abhishek-kakkar/beaglelogic-standalone/README.md

# beaglelogic-standalone

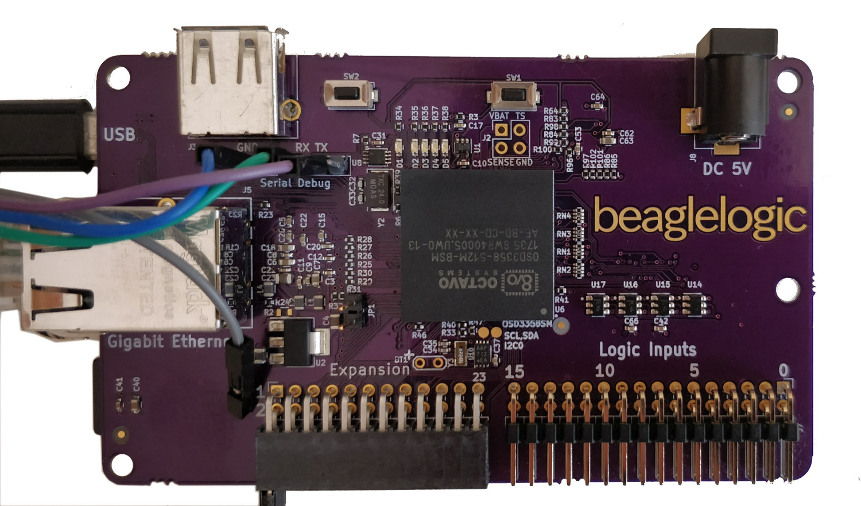
[picture p1: beaglelogic-standalone-top.jpg]
BeagleLogic standalone


BeagleLogic implemented as a turnkey and standalone logic analyzer
