abhishek-kakkar/beaglelogic-standalone/docs/tech_specs.rst

Technical Specifications
=========================

 * **Sample Rate**: 1 Hz to 100MHz (16 channels)
 * **Sample Depth**: Default 128 MiB, can be increased up to 300MiB
   (3 seconds, 8 channels or 1.5 seconds at 16 channels)
 * **Input impedance**: 1 MOhm on each channel
 * **Logic level thresholds supported**: 1.8V, 3.3V.
 * **Max voltage on a logic input pin**: currently 5V. Hardware can support
   taking up to 12V logic levels in a future revision
 * **Interfaces**: USB 2.0 Host and Client, Gigabit Ethernet.
