abhishek-kakkar/beaglelogic-standalone/beaglelogic-standalone.kicad_pcb

## KiCad design beaglelogic-standalone.kicad_pcb (2017-10-14)

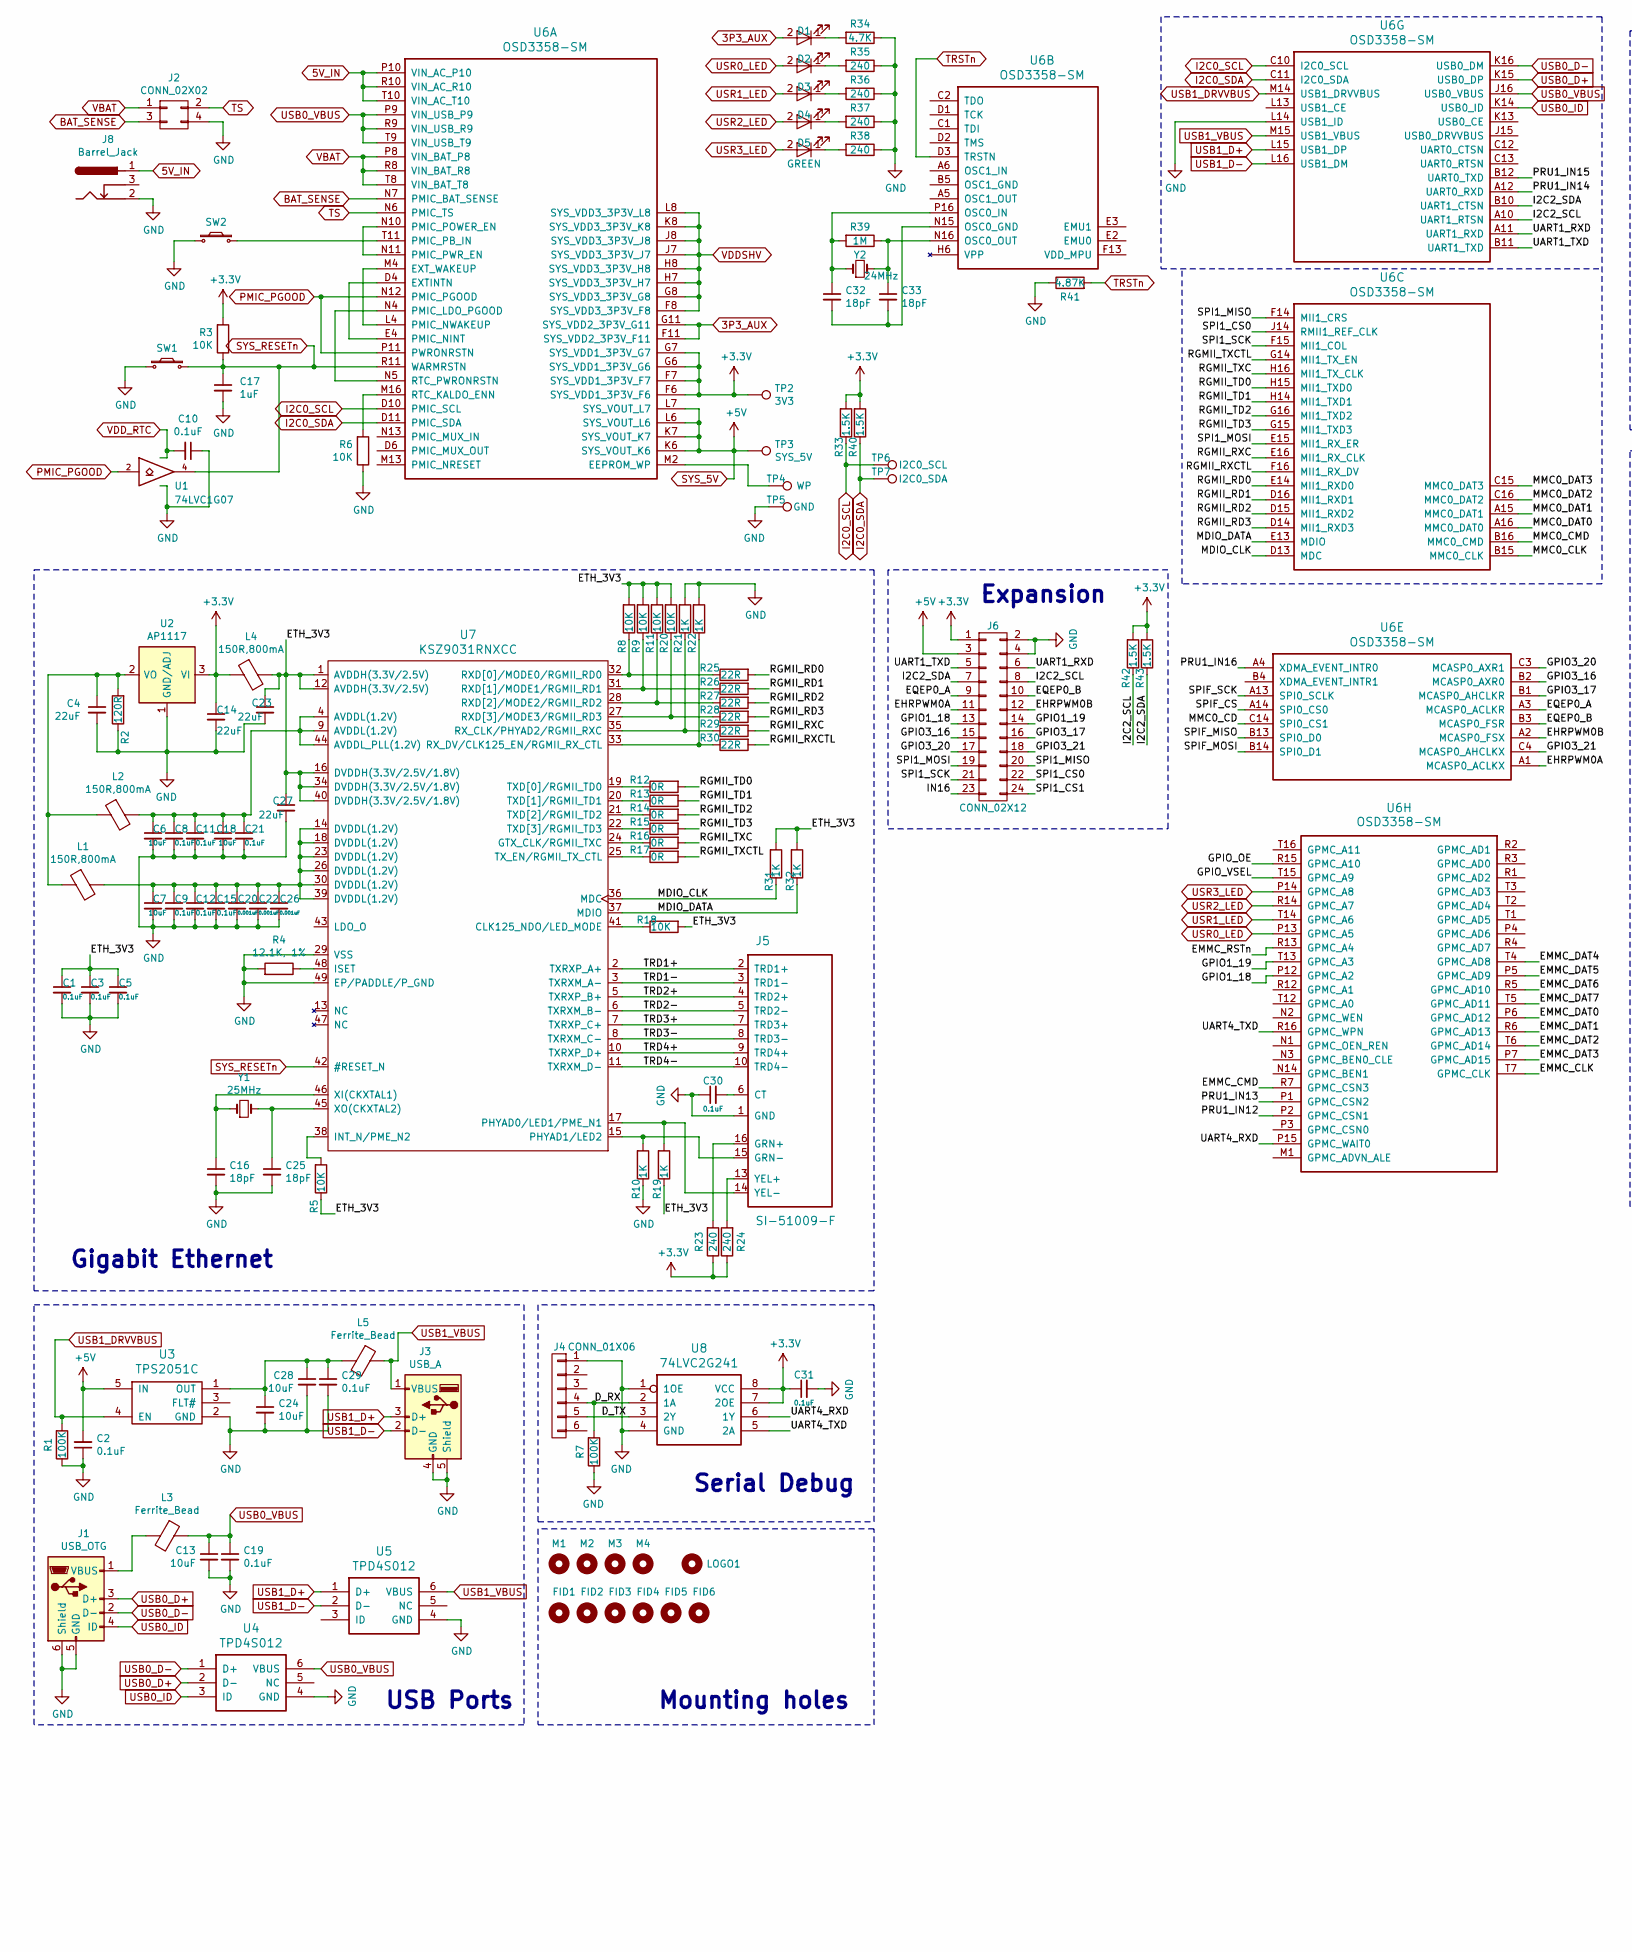
[picture p6: schematic beaglelogic-standalone.sch, BeagleLogic Standalone, part in row 1, column 1]

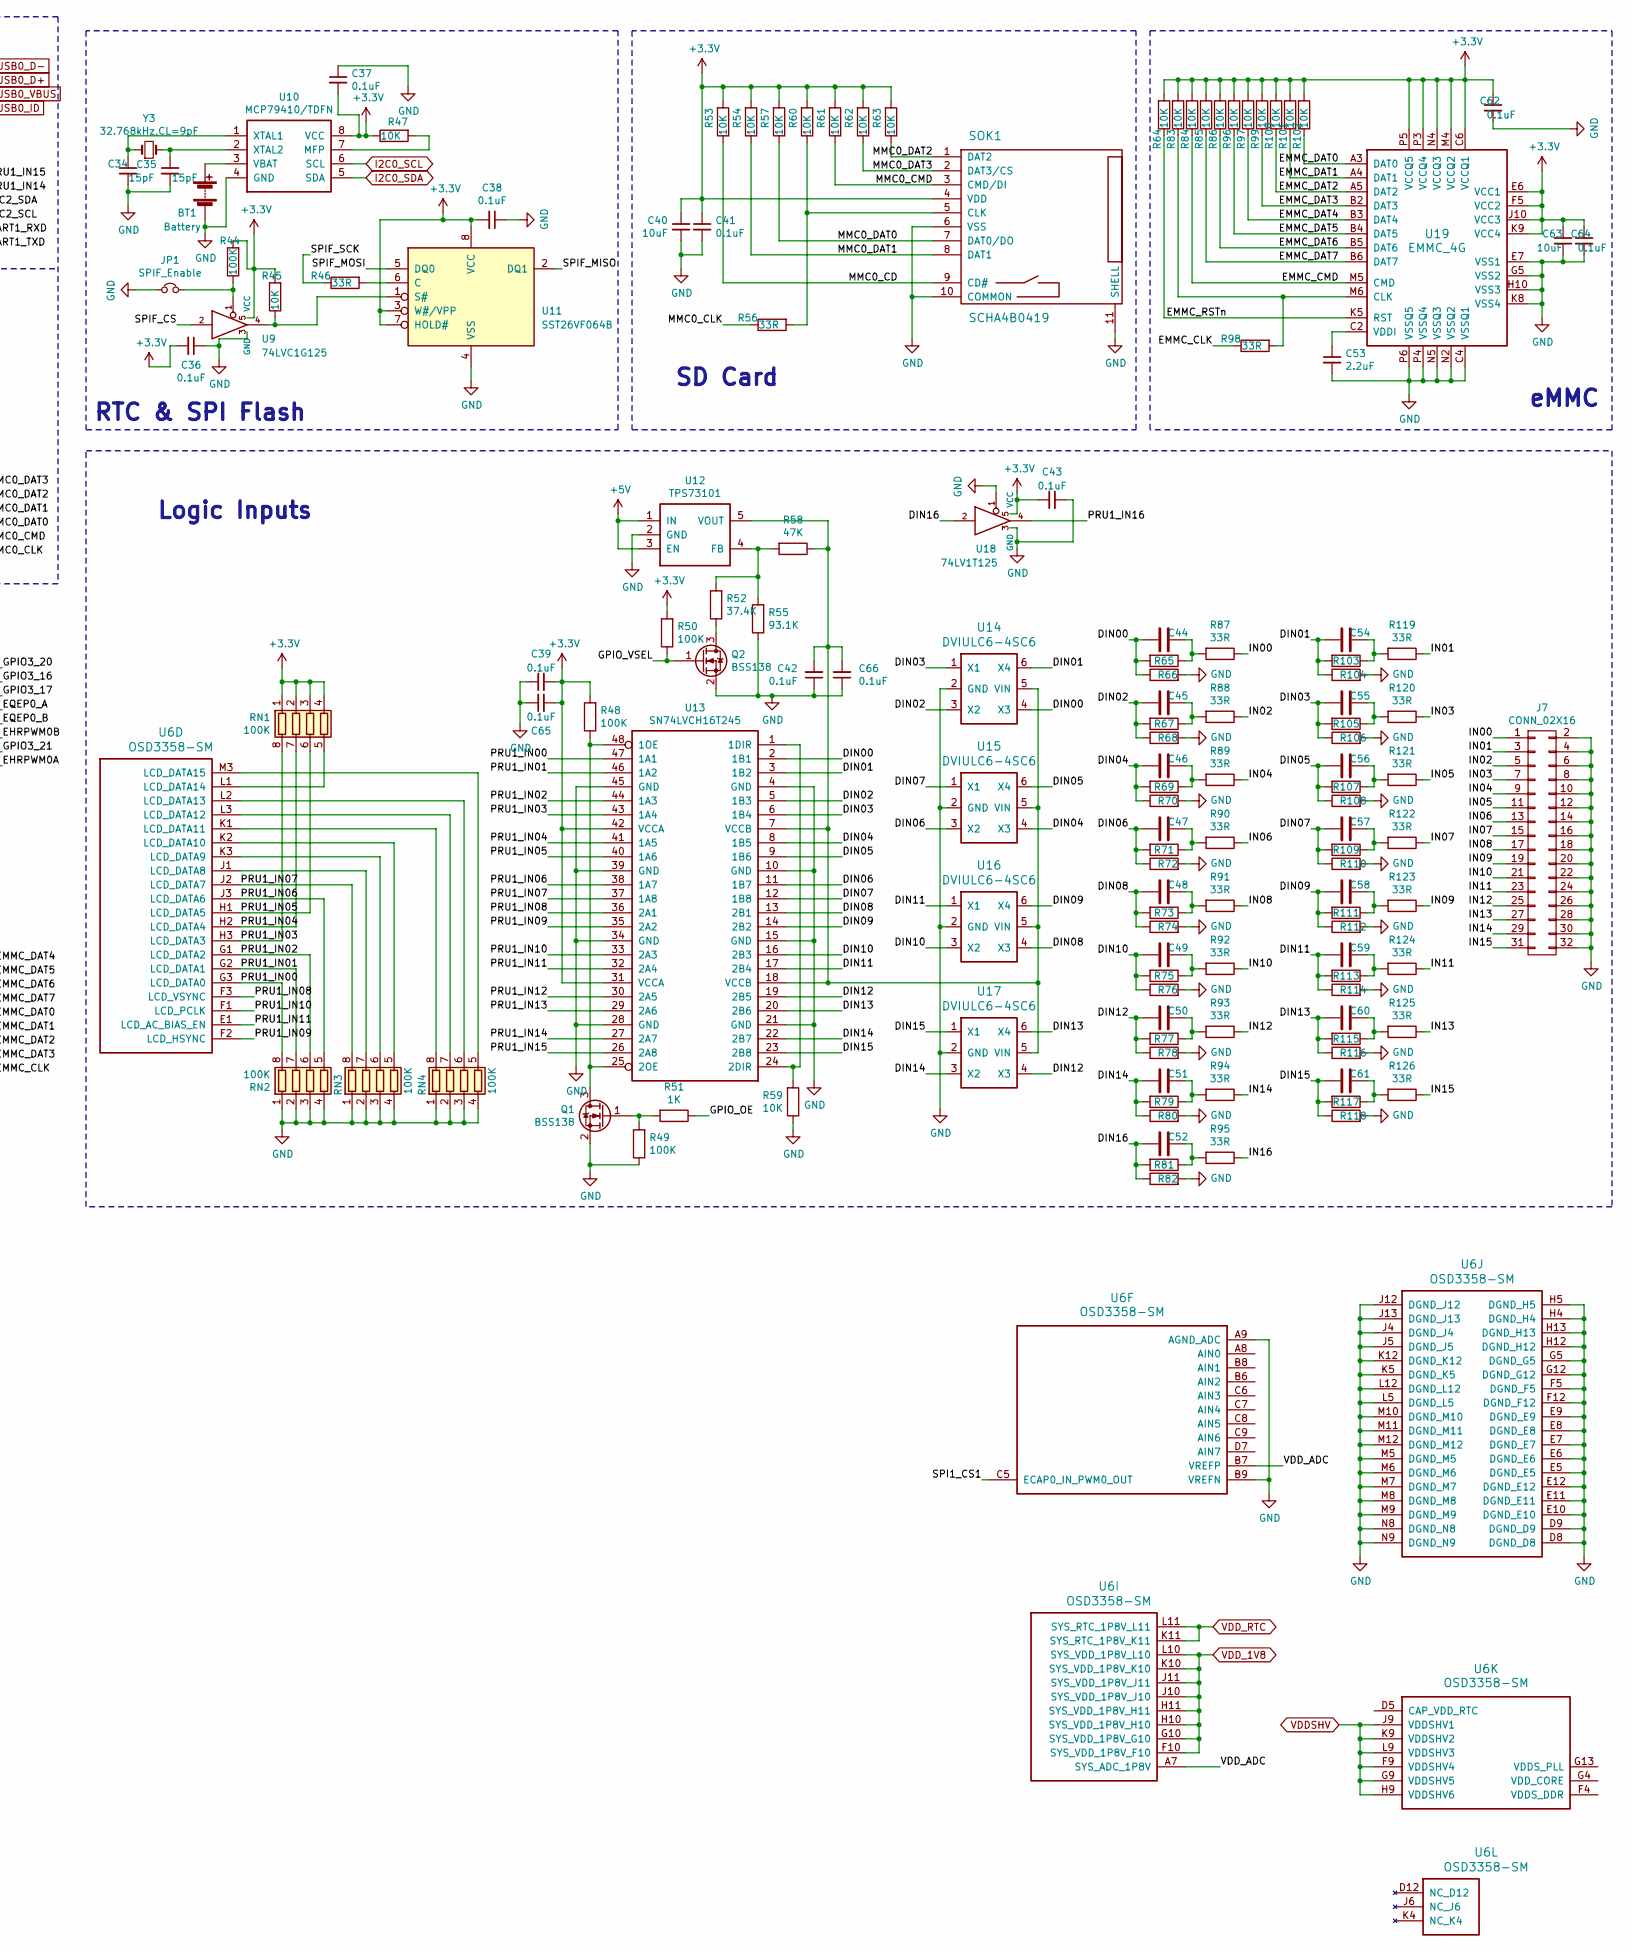
[picture p7: schematic beaglelogic-standalone.sch, BeagleLogic Standalone, part in row 1, column 2]

Parts:
BT1: Battery; Test_Point_2Pads
C1, C2, C3, C5, C8, C9, C10, C11, C12, C15, C19, C21, C29, C30, C31, C36, C37, C38, C39, C41, C42, C43, C62, C64, C65, C66: 0.1uF; C_0402
C4, C14, C23, C27: 22uF; C_0603
C6, C7, C13, C18, C24, C28, C40, C63: 10uF; C_0603
C16, C25, C32, C33: 18pF; C_0402
C17: 1uF; C_0402
C20, C22, C26: 0.001uF; C_0402
C34, C35: 15pF; C_0402
C44, C45, C46, C47, C48, C49, C50, C51, C52, C54, C55, C56, C57, C58, C59, C60, C61: 1pF, DNI; C_0402
C53: 2.2uF; C_0402
D1, D2, D3, D4, D5: GREEN; LED_0603
FID1, FID2, FID3, FID4, FID5, FID6: Mounting_Hole; Fiducial_1mm_Dia_2.54mm_Outer_CopperTop
J1: USB_OTG; 10118192-0001LF
J2: CONN_02X02; Pin_Header_Straight_2x02_Pitch2.54mm
J3: USB_A
J4: CONN_01X06; Pin_Header_Straight_1x06_Pitch2.54mm
J5: SI-51009-F
J6: CONN_02X12; Pin_Header_Angled_2x12_Pitch2.54mm_reversed
J7: CONN_02X16; Pin_Header_Angled_2x16_Pitch2.54mm
J8: Barrel_Jack; BARREL_JACK
JP1: SPIF_Enable; Test_Point_2Pads
L1, L2, L4: 150R,800mA; R_0603
L3, L5: Ferrite_Bead; R_0603
LOGO1: TEST_1P; beaglelogic-logo
M1, M2, M3, M4: TEST_1P; MountingHole_3.2mm_M3
Q1, Q2: BSS138; SOT-23
R1, R7, R44, R48, R49, R50: 100K; R_0402
R2: 120R; R_0603
R3, R5, R6, R8, R9, R11, R18, R20, R45, R47, R53, R54, R57, R59, R60, R61, R62, R63, R64, R83, R84, R85, R86, R96, R97, R99, R100, R101, R102: 10K; R_0402
R4: 12.1K, 1%; R_0402
R10, R19, R21, R22, R31, R32, R51: 1K; R_0402
R12, R13, R14, R15, R16, R17: 0R; R_0402
R23, R24, R35, R36, R37, R38: 240; R_0402
R25, R26, R27, R28, R29, R30: 22R; R_0402
R33, R40, R42, R43: 1.5K; R_0402
R34: 4.7K; R_0402
R39: 1M; R_0402
R41: 4.87K; R_0402
R46, R56, R87, R88, R89, R90, R91, R92, R93, R94, R95, R98, R119, R120, R121, R122, R123, R124, R125, R126: 33R; R_0402
R52: 37.4K; R_0402
R55: 93.1K; R_0402
R58: 47K; R_0402
R65, R67, R69, R71, R73, R75, R77, R79, R81, R103, R105, R107, R109, R111, R113, R115, R117: 100K,SH; R_0402
R66, R68, R70, R72, R74, R76, R78, R80, R82, R104, R106, R108, R110, R112, R114, R116, R118: 1M,S; R_0402
RN1, RN2, RN3, RN4: 100K; R_Array_Concave_4x0402
SOK1: SCHA4B0419
SW1, SW2: SW_PUSH_SMALL_H; SW_SPST_EVQPE1
TP2: 3V3; Measurement_Point_Round-SMD-Pad_Small
TP3: SYS_5V; Measurement_Point_Round-SMD-Pad_Small
TP4: WP; Measurement_Point_Round-SMD-Pad_Small
TP5: GND; Measurement_Point_Round-SMD-Pad_Small
TP6: I2C0_SCL; Measurement_Point_Round-SMD-Pad_Small
TP7: I2C0_SDA; Measurement_Point_Round-SMD-Pad_Small
U1: 74LVC1G07; SOT-353_SC-70-5
U2: AP1117; SOT-223
U3: TPS2051C; SOT-23-5
U4, U5: TPD4S012; DRY
U6: OSD3358-SM; BGA-256-1-27mm
U7: KSZ9031RNXCC; QFN-48-1EP_7x7mm
U8: 74LVC2G241; VSSOP-8_2.4x2.1mm_Pitch0.5mm
U9: 74LVC1G125; SOT-353_SC-70-5
U10: MCP79410/TDFN; DFN-8-1EP_3x2mm
U11: SST26VF064B; SOIJ-8_5.3x5.3mm_Pitch1.27mm
U12: TPS73101; SOT-23-5
U13: SN74LVCH16T245; TSSOP-48_6.1x12.5mm_Pitch0.5mm
U14, U15, U16, U17: DVIULC6-4SC6; SOT-23-6
U18: 74LV1T125; SOT-353_SC-70-5
U19: EMMC_4G; BGA153N50P14X14_1150X1300X100
Y1: 25MHz; Crystal_SMD_5032-2pin_5.0x3.2mm
Y2: 24MHz; Crystal_SMD_5032-2pin_5.0x3.2mm
Y3: 32.768kHz,CL=9pF; Crystal_SMD_3215-2pin_3.2x1.5mm

Connections:
3P3_AUX: D1.2 (A), U6.F11 (SYS_VDD2_3P3V_F11), U6.G11 (SYS_VDD2_3P3V_G11)
5V_IN: J8.1, U6.P10 (VIN_AC_P10), U6.R10 (VIN_AC_R10), U6.T10 (VIN_AC_T10)
+3V3: C14.1, C31.1, C36.2, C37.2, C38.2, C39.2, C40.1, C41.1, C43.1, C62.1, C63.1, C64.1, C65.2, J6.1, L4.1, R3.2, R23.1, R24.1, R33.2, R40.2, R42.2, R43.2, R44.2, R45.2, R47.1, R48.2, R50.2, R53.2, R54.2, R57.2, R60.2, R61.2, R62.2, R63.2, R64.2, R83.2, R84.2, R85.2, R86.2, R96.2, R97.2, R99.2, R100.2, R101.2, R102.2, RN1.1 (R1.1), RN1.2 (R2.1), RN1.3 (R3.1), RN1.4 (R4.1), SOK1.4 (VDD), TP2.1, U2.3 (VI), U6.F6 (SYS_VDD1_3P3V_F6), U6.F7 (SYS_VDD1_3P3V_F7), U6.G6 (SYS_VDD1_3P3V_G6), U6.G7 (SYS_VDD1_3P3V_G7), U8.7 (2OE), U8.8 (VCC), U9.5 (VCC), U10.8 (VCC), U11.3 (W#/VPP), U11.7 (HOLD#), U11.8 (VCC), U13.31 (VCCA), U13.42 (VCCA), U18.5 (VCC), U19.C6 (VCCQ1), U19.E6 (VCC1), U19.F5 (VCC2), U19.J10 (VCC3), U19.K9 (VCC4), U19.M4 (VCCQ2), U19.N4 (VCCQ3), U19.P3 (VCCQ4), U19.P5 (VCCQ5)
/DIN00: C44.2, R65.2, R66.1, U13.2 (1B1), U14.4 (X3)
/DIN01: C54.2, R103.2, R104.1, U13.3 (1B2), U14.6 (X4)
/DIN02: C45.2, R67.2, R68.1, U13.5 (1B3), U14.3 (X2)
/DIN03: C55.2, R105.2, R106.1, U13.6 (1B4), U14.1 (X1)
/DIN04: C46.2, R69.2, R70.1, U13.8 (1B5), U15.4 (X3)
/DIN05: C56.2, R107.2, R108.1, U13.9 (1B6), U15.6 (X4)
/DIN06: C47.2, R71.2, R72.1, U13.11 (1B7), U15.3 (X2)
/DIN07: C57.2, R109.2, R110.1, U13.12 (1B8), U15.1 (X1)
/DIN08: C48.2, R73.2, R74.1, U13.13 (2B1), U16.4 (X3)
/DIN09: C58.2, R111.2, R112.1, U13.14 (2B2), U16.6 (X4)
/DIN10: C49.2, R75.2, R76.1, U13.16 (2B3), U16.3 (X2)
/DIN11: C59.2, R113.2, R114.1, U13.17 (2B4), U16.1 (X1)
/DIN12: C50.2, R77.2, R78.1, U13.19 (2B5), U17.4 (X3)
/DIN13: C60.2, R115.2, R116.1, U13.20 (2B6), U17.6 (X4)
/DIN14: C51.2, R79.2, R80.1, U13.22 (2B7), U17.3 (X2)
/DIN15: C61.2, R117.2, R118.1, U13.23 (2B8), U17.1 (X1)
/DIN16: C52.2, R81.2, R82.1, U18.2
/D_RX: J4.4, R7.2, U8.2 (1A)
/D_TX: J4.5, U8.3 (2Y)
/EHRPWM0A: J6.11, U6.A1 (MCASP0_ACLKX)
/EHRPWM0B: J6.12, U6.A2 (MCASP0_FSX)
/EMMC_CLK: R98.1, U6.T7 (GPMC_CLK)
/EMMC_CMD: R84.1, U6.R7 (GPMC_CSN3), U19.M5 (CMD)
/EMMC_DAT0: R102.1, U6.P6 (GPMC_AD12), U19.A3 (DAT0)
/EMMC_DAT1: R101.1, U6.R6 (GPMC_AD13), U19.A4 (DAT1)
/EMMC_DAT2: R100.1, U6.T6 (GPMC_AD14), U19.A5 (DAT2)
/EMMC_DAT3: R99.1, U6.P7 (GPMC_AD15), U19.B2 (DAT3)
/EMMC_DAT4: R97.1, U6.T4 (GPMC_AD8), U19.B3 (DAT4)
/EMMC_DAT5: R96.1, U6.P5 (GPMC_AD9), U19.B4 (DAT5)
/EMMC_DAT6: R86.1, U6.R5 (GPMC_AD10), U19.B5 (DAT6)
/EMMC_DAT7: R85.1, U6.T5 (GPMC_AD11), U19.B6 (DAT7)
/EMMC_RSTn: R64.1, U6.R13 (GPMC_A4), U19.K5 (RST)
/EQEP0_A: J6.9, U6.A3 (MCASP0_ACLKR)
/EQEP0_B: J6.10, U6.B3 (MCASP0_FSR)
/ETH_3V3: C1.1, C3.1, C5.1, C23.1, C27.1, L4.2, R5.1, R8.2, R9.2, R11.2, R18.2, R19.1, R20.2, R31.2, R32.2, U7.1 (AVDDH(3.3V/2.5V)), U7.12 (AVDDH(3.3V/2.5V)), U7.16 (DVDDH(3.3V/2.5V/1.8V)), U7.34 (DVDDH(3.3V/2.5V/1.8V)), U7.40 (DVDDH(3.3V/2.5V/1.8V))
/GPIO1_18: J6.13, U6.P12 (GPMC_A2)
/GPIO1_19: J6.14, U6.T13 (GPMC_A3)
/GPIO3_16: J6.15, U6.B2 (MCASP0_AXR0)
/GPIO3_17: J6.16, U6.B1 (MCASP0_AHCLKR)
/GPIO3_20: J6.17, U6.C3 (MCASP0_AXR1)
/GPIO3_21: J6.18, U6.C4 (MCASP0_AHCLKX)
/GPIO_OE: R51.1, U6.R15 (GPMC_A10)
/GPIO_VSEL: Q2.1 (G), R50.1, U6.T15 (GPMC_A9)
/I2C2_SCL: J6.8, R42.1, U6.A10 (UART1_RTSN)
/I2C2_SDA: J6.7, R43.1, U6.B10 (UART1_CTSN)
/IN00: J7.1, R87.1
/IN01: J7.3, R119.1
/IN02: J7.5, R88.1
/IN03: J7.7, R120.1
/IN04: J7.9, R89.1
/IN05: J7.11, R121.1
/IN06: J7.13, R90.1
/IN07: J7.15, R122.1
/IN08: J7.17, R91.1
/IN09: J7.19, R123.1
/IN10: J7.21, R92.1
/IN11: J7.23, R124.1
/IN12: J7.25, R93.1
/IN13: J7.27, R125.1
/IN14: J7.29, R94.1
/IN15: J7.31, R126.1
/IN16: J6.23, R95.1
/MDIO_CLK: R31.1, U6.D13 (MDC), U7.36 (MDC)
/MDIO_DATA: R32.1, U6.E13 (MDIO), U7.37 (MDIO)
/MMC0_CD: R53.1, SOK1.9 (CD#), U6.C14 (SPI0_CS1)
/MMC0_CLK: R56.1, U6.B15 (MMC0_CLK)
/MMC0_CMD: R61.1, SOK1.3 (CMD/DI), U6.B16 (MMC0_CMD)
/MMC0_DAT0: R57.1, SOK1.7 (DAT0/DO), U6.A16 (MMC0_DAT0)
/MMC0_DAT1: R54.1, SOK1.8 (DAT1), U6.A15 (MMC0_DAT1)
/MMC0_DAT2: R63.1, SOK1.1 (DAT2), U6.C16 (MMC0_DAT2)
/MMC0_DAT3: R62.1, SOK1.2 (DAT3/CS), U6.C15 (MMC0_DAT3)
/PRU1_IN00: RN2.8 (R1.2), U6.G3 (LCD_DATA0), U13.47 (1A1)
/PRU1_IN01: RN2.7 (R2.2), U6.G2 (LCD_DATA1), U13.46 (1A2)
/PRU1_IN02: RN2.6 (R3.2), U6.G1 (LCD_DATA2), U13.44 (1A3)
/PRU1_IN03: RN1.8 (R1.2), U6.H3 (LCD_DATA3), U13.43 (1A4)
/PRU1_IN04: RN1.7 (R2.2), U6.H2 (LCD_DATA4), U13.41 (1A5)
/PRU1_IN05: RN1.6 (R3.2), U6.H1 (LCD_DATA5), U13.40 (1A6)
/PRU1_IN06: RN2.5 (R4.2), U6.J3 (LCD_DATA6), U13.38 (1A7)
/PRU1_IN07: RN3.8 (R1.2), U6.J2 (LCD_DATA7), U13.37 (1A8)
/PRU1_IN08: U6.F3 (LCD_VSYNC), U13.36 (2A1)
/PRU1_IN09: U6.F2 (LCD_HSYNC), U13.35 (2A2)
/PRU1_IN10: U6.F1 (LCD_PCLK), U13.33 (2A3)
/PRU1_IN11: U6.E1 (LCD_AC_BIAS_EN), U13.32 (2A4)
/PRU1_IN12: U6.P2 (GPMC_CSN1), U13.30 (2A5)
/PRU1_IN13: U6.P1 (GPMC_CSN2), U13.29 (2A6)
/PRU1_IN14: U6.A12 (UART0_RXD), U13.27 (2A7)
/PRU1_IN15: U6.B12 (UART0_TXD), U13.26 (2A8)
/PRU1_IN16: U6.A4 (XDMA_EVENT_INTR0), U18.4
/RGMII_RD0: R25.2, U6.E14 (MII1_RXD0)
/RGMII_RD1: R26.2, U6.D16 (MII1_RXD1)
/RGMII_RD2: R27.2, U6.D15 (MII1_RXD2)
/RGMII_RD3: R28.2, U6.D14 (MII1_RXD3)
/RGMII_RXC: R29.2, U6.E16 (MII1_RX_CLK)
/RGMII_RXCTL: R30.2, U6.F16 (MII1_RX_DV)
/RGMII_TD0: R12.2, U6.H15 (MII1_TXD0)
/RGMII_TD1: R13.2, U6.H14 (MII1_TXD1)
/RGMII_TD2: R14.2, U6.G16 (MII1_TXD2)
/RGMII_TD3: R15.2, U6.G15 (MII1_TXD3)
/RGMII_TXC: R16.2, U6.H16 (MII1_TX_CLK)
/RGMII_TXCTL: R17.2, U6.G14 (MII1_TX_EN)
/SPI1_CS0: J6.22, U6.J14 (RMII1_REF_CLK)
/SPI1_CS1: J6.24, U6.C5 (ECAP0_IN_PWM0_OUT)
/SPI1_MISO: J6.20, U6.F14 (MII1_CRS)
/SPI1_MOSI: J6.19, U6.E15 (MII1_RX_ER)
/SPI1_SCK: J6.21, U6.F15 (MII1_COL)
/SPIF_CS: U6.A14 (SPI0_CS0), U9.2
/SPIF_MISO: U6.B13 (SPI0_D0), U11.2 (DQ1)
/SPIF_MOSI: U6.B14 (SPI0_D1), U11.5 (DQ0)
/SPIF_SCK: R46.1, U6.A13 (SPI0_SCLK)
/TRD1+: J5.2 (TRD1+), U7.2 (TXRXP_A+)
/TRD1-: J5.3 (TRD1-), U7.3 (TXRXM_A-)
/TRD2+: J5.4 (TRD2+), U7.5 (TXRXP_B+)
/TRD2-: J5.5 (TRD2-), U7.6 (TXRXM_B-)
/TRD3+: J5.7 (TRD3+), U7.7 (TXRXP_C+)
/TRD3-: J5.8 (TRD3-), U7.8 (TXRXM_C-)
/TRD4+: J5.9 (TRD4+), U7.10 (TXRXP_D+)
/TRD4-: J5.10 (TRD4-), U7.11 (TXRXM_D-)
/UART1_RXD: J6.6, U6.A11 (UART1_RXD)
/UART1_TXD: J6.5, U6.B11 (UART1_TXD)
/UART4_RXD: U6.P15 (GPMC_WAIT0), U8.6 (1Y)
/UART4_TXD: U6.R16 (GPMC_WPN), U8.5 (2A)
/VDD_ADC: U6.A7 (SYS_ADC_1P8V), U6.B7 (VREFP)
BAT_SENSE: J2.3, U6.N7 (PMIC_BAT_SENSE)
GND: BT1.2 (-), C1.2, C2.1, C3.2, C4.2, C5.2, C6.2, C7.2, C8.2, C9.2, C10.1, C11.2, C12.2, C13.2, C14.2, C15.2, C16.2, C17.2, C18.2, C19.2, C20.2, C21.2, C22.2, C23.2, C24.2, C25.2, C26.2, C27.2, C28.2, C29.2, C30.1, C31.2, C34.2, C35.2, C36.1, C37.1, C38.1, C39.1, C40.2, C41.2, C42.1, C43.2, C53.2, C62.2, C63.2, C64.2, C65.1, C66.1, J1.5 (GND), J1.6 (Shield), J2.4, J3.4 (GND), J3.5 (Shield), J4.1, J5.1 (GND), J6.2, J6.4, J7.2, J7.4, J7.6, J7.8, J7.10, J7.12, J7.14, J7.16, J7.18, J7.20, J7.22, J7.24, J7.26, J7.28, J7.30, J7.32, J8.2, JP1.1, Q1.2 (S), Q2.2 (S), R1.1, R2.1, R4.2, R6.1, R7.1, R10.1, R21.2, R22.2, R34.1, R35.1, R36.1, R37.1, R38.1, R41.1, R49.1, R55.1, R59.1, R66.2, R68.2, R70.2, R72.2, R74.2, R76.2, R78.2, R80.2, R82.2, R104.2, R106.2, R108.2, R110.2, R112.2, R114.2, R116.2, R118.2, RN2.1 (R1.1), RN2.2 (R2.1), RN2.3 (R3.1), RN2.4 (R4.1), RN3.1 (R1.1), RN3.2 (R2.1), RN3.3 (R3.1), RN3.4 (R4.1), RN4.1 (R1.1), RN4.2 (R2.1), RN4.3 (R3.1), RN4.4 (R4.1), SOK1.6 (VSS), SOK1.10 (COMMON), SOK1.11 (SHELL), SW1.1, SW2.1, TP5.1, U1.3 (GND), U2.1 (GND/ADJ), U3.2 (GND), U4.4 (GND), U5.4 (GND), U6.A9 (AGND_ADC), U6.B9 (VREFN), U6.D8 (DGND_D8), U6.D9 (DGND_D9), U6.E5 (DGND_E5), U6.E6 (DGND_E6), U6.E7 (DGND_E7), U6.E8 (DGND_E8), U6.E9 (DGND_E9), U6.E10 (DGND_E10), U6.E11 (DGND_E11), U6.E12 (DGND_E12), U6.F5 (DGND_F5), U6.F12 (DGND_F12), U6.G5 (DGND_G5), U6.G12 (DGND_G12), U6.H4 (DGND_H4), U6.H5 (DGND_H5), U6.H12 (DGND_H12), U6.H13 (DGND_H13), U6.J4 (DGND_J4), U6.J5 (DGND_J5), U6.J12 (DGND_J12), U6.J13 (DGND_J13), U6.K5 (DGND_K5), U6.K12 (DGND_K12), U6.L5 (DGND_L5), U6.L12 (DGND_L12), U6.L14 (USB1_ID), U6.M5 (DGND_M5), U6.M6 (DGND_M6), U6.M7 (DGND_M7), U6.M8 (DGND_M8), U6.M9 (DGND_M9), U6.M10 (DGND_M10), U6.M11 (DGND_M11), U6.M12 (DGND_M12), U6.N8 (DGND_N8), U6.N9 (DGND_N9), U7.29 (VSS), U7.49 (EP/PADDLE/P_GND), U8.1 (1OE), U8.4 (GND), U9.3 (GND), U10.4 (GND), U11.4 (VSS), U12.2 (GND), U13.4 (GND), U13.10 (GND), U13.15 (GND), U13.21 (GND), U13.28 (GND), U13.34 (GND), U13.39 (GND), U13.45 (GND), U14.2 (GND), U15.2 (GND), U16.2 (GND), U17.2 (GND), U18.1, U18.3 (GND), U19.C4 (VSSQ1), U19.E7 (VSS1), U19.G5 (VSS2), U19.H10 (VSS3), U19.K8 (VSS4), U19.N2 (VSSQ2), U19.N5 (VSSQ3), U19.P4 (VSSQ4), U19.P6 (VSSQ5)
I2C0_SCL: R33.1, TP6.1, U6.C10 (I2C0_SCL), U6.D10 (PMIC_SCL), U10.6 (SCL)
I2C0_SDA: R40.1, TP7.1, U6.C11 (I2C0_SDA), U6.D11 (PMIC_SDA), U10.5 (SDA)
unnamed: BT1.1 (+), U10.3 (VBAT)
unnamed: C4.1, L1.1, L2.1, R2.2, U2.2 (VO), U2.4 (VO)
unnamed: C6.1, C8.1, C11.1, C18.1, C21.1, L2.2, U7.4 (AVDDL(1.2V)), U7.9 (AVDDL(1.2V)), U7.44 (AVDDL_PLL(1.2V))
unnamed: C7.1, C9.1, C12.1, C15.1, C20.1, C22.1, C26.1, L1.2, U7.14 (DVDDL(1.2V)), U7.18 (DVDDL(1.2V)), U7.23 (DVDDL(1.2V)), U7.26 (DVDDL(1.2V)), U7.30 (DVDDL(1.2V)), U7.39 (DVDDL(1.2V))
unnamed: C16.1, U7.46 (XI(CKXTAL1)), Y1.1
unnamed: C24.1, C28.1, C29.1, L5.2, U3.1 (OUT)
unnamed: C25.1, U7.45 (XO(CKXTAL2)), Y1.2
unnamed: C30.2, J5.6 (CT)
unnamed: C32.1, R39.2, U6.P16 (OSC0_IN), Y2.1
unnamed: C32.2, C33.2, U6.N15 (OSC0_GND)
unnamed: C33.1, R39.1, U6.N16 (OSC0_OUT), Y2.2
unnamed: C34.1, U10.1 (XTAL1), Y3.1
unnamed: C35.1, U10.2 (XTAL2), Y3.2
unnamed: C42.2, C66.2, R58.1, U12.5 (VOUT), U13.7 (VCCB), U13.18 (VCCB), U14.5 (VIN), U15.5 (VIN), U16.5 (VIN), U17.5 (VIN)
unnamed: C44.1, R65.1, R87.2
unnamed: C45.1, R67.1, R88.2
unnamed: C46.1, R69.1, R89.2
unnamed: C47.1, R71.1, R90.2
unnamed: C48.1, R73.1, R91.2
unnamed: C49.1, R75.1, R92.2
unnamed: C50.1, R77.1, R93.2
unnamed: C51.1, R79.1, R94.2
unnamed: C52.1, R81.1, R95.2
unnamed: C53.1, U19.C2 (VDDI)
unnamed: C54.1, R103.1, R119.2
unnamed: C55.1, R105.1, R120.2
unnamed: C56.1, R107.1, R121.2
unnamed: C57.1, R109.1, R122.2
unnamed: C58.1, R111.1, R123.2
unnamed: C59.1, R113.1, R124.2
unnamed: C60.1, R115.1, R125.2
unnamed: C61.1, R117.1, R126.2
unnamed: D1.1 (K), R34.2
unnamed: D2.1 (K), R35.2
unnamed: D3.1 (K), R36.2
unnamed: D4.1 (K), R37.2
unnamed: D5.1 (K), R38.2
unnamed: J1.1 (VBUS), L3.2
unnamed: J5.13 (YEL+), R24.2
unnamed: J5.14 (YEL-), R19.2, U7.17 (PHYAD0/LED1/PME_N1)
unnamed: J5.15 (GRN-), R10.2, U7.15 (PHYAD1/LED2)
unnamed: J5.16 (GRN+), R23.2
unnamed: JP1.2, R44.1, U9.1
unnamed: Q1.1 (G), R49.2, R51.2
unnamed: Q1.3 (D), R48.1, U13.25 (2OE), U13.48 (1OE)
unnamed: Q2.3 (D), R52.1
unnamed: R4.1, U7.48 (ISET)
unnamed: R5.2, U7.38 (INT_N/PME_N2)
unnamed: R6.2, U6.M16 (RTC_KALDO_ENN)
unnamed: R11.1, R27.1, U7.28 (RXD[2]/MODE2/RGMII_RD2)
unnamed: R12.1, U7.19 (TXD[0]/RGMII_TD0)
unnamed: R13.1, U7.20 (TXD[1]/RGMII_TD1)
unnamed: R14.1, U7.21 (TXD[2]/RGMII_TD2)
unnamed: R15.1, U7.22 (TXD[3]/RGMII_TD3)
unnamed: R16.1, U7.24 (GTX_CLK/RGMII_TXC)
unnamed: R17.1, U7.25 (TX_EN/RGMII_TX_CTL)
unnamed: R18.1, U7.41 (CLK125_NDO/LED_MODE)
unnamed: R20.1, R28.1, U7.27 (RXD[3]/MODE3/RGMII_RD3)
unnamed: R21.1, R29.1, U7.35 (RX_CLK/PHYAD2/RGMII_RXC)
unnamed: R22.1, R30.1, U7.33 (RX_DV/CLK125_EN/RGMII_RX_CTL)
unnamed: R8.1, R25.1, U7.32 (RXD[0]/MODE0/RGMII_RD0)
unnamed: R9.1, R26.1, U7.31 (RXD[1]/MODE1/RGMII_RD1)
unnamed: R45.1, U9.4, U11.1 (S#)
unnamed: R46.2, U11.6 (C)
unnamed: R47.2, U10.7 (MFP)
unnamed: R52.2, R55.2, R58.2, U12.4 (FB)
unnamed: R56.2, R60.1, SOK1.5 (CLK)
unnamed: R59.2, U13.1 (1DIR), U13.24 (2DIR)
unnamed: R83.1, R98.2, U19.M6 (CLK)
unnamed: RN1.5 (R4.2), U6.L1 (LCD_DATA14)
unnamed: RN3.5 (R4.2), U6.K2 (LCD_DATA10)
unnamed: RN3.6 (R3.2), U6.K3 (LCD_DATA9)
unnamed: RN3.7 (R2.2), U6.J1 (LCD_DATA8)
unnamed: RN4.5 (R4.2), U6.M3 (LCD_DATA15)
unnamed: RN4.6 (R3.2), U6.L2 (LCD_DATA13)
unnamed: RN4.7 (R2.2), U6.L3 (LCD_DATA12)
unnamed: RN4.8 (R1.2), U6.K1 (LCD_DATA11)
unnamed: SW2.2, U6.T11 (PMIC_PB_IN)
unnamed: TP4.1, U6.M2 (EEPROM_WP)
unnamed: U6.D4 (EXTINTN), U6.E4 (PMIC_NINT)
unnamed: U6.L4 (PMIC_NWAKEUP), U6.M4 (EXT_WAKEUP)
unnamed: U6.N4 (PMIC_LDO_PGOOD), U6.N5 (RTC_PWRONRSTN)
unnamed: U6.N10 (PMIC_POWER_EN), U6.N11 (PMIC_PWR_EN)
PMIC_PGOOD: U1.2, U6.N12 (PMIC_PGOOD), U6.P11 (PWRONRSTN)
SYS_5V: C2.2, J6.3, TP3.1, U3.5 (IN), U6.K6 (SYS_VOUT_K6), U6.K7 (SYS_VOUT_K7), U6.L6 (SYS_VOUT_L6), U6.L7 (SYS_VOUT_L7), U12.1 (IN), U12.3 (EN)
SYS_RESETn: C17.1, R3.1, SW1.2, U1.4, U6.R11 (WARMRSTN), U7.42 (#RESET_N)
TRSTn: R41.2, U6.D3 (TRSTN)
TS: J2.2, U6.N6 (PMIC_TS)
USB0_D+: J1.3 (D+), U4.2 (D-), U6.K15 (USB0_DP)
USB0_D-: J1.2 (D-), U4.1 (D+), U6.K16 (USB0_DM)
USB0_ID: J1.4 (ID), U4.3 (ID), U6.K14 (USB0_ID)
USB0_VBUS: C13.1, C19.1, L3.1, U4.6 (VBUS), U6.J16 (USB0_VBUS), U6.P9 (VIN_USB_P9), U6.R9 (VIN_USB_R9), U6.T9 (VIN_USB_T9)
USB1_D+: J3.3 (D+), U5.1 (D+), U6.L15 (USB1_DP)
USB1_D-: J3.2 (D-), U5.2 (D-), U6.L16 (USB1_DM)
USB1_DRVVBUS: R1.2, U3.4 (EN), U6.M14 (USB1_DRVVBUS)
USB1_VBUS: J3.1 (VBUS), L5.1, U5.6 (VBUS), U6.M15 (USB1_VBUS)
USR0_LED: D2.2 (A), U6.P13 (GPMC_A5)
USR1_LED: D3.2 (A), U6.T14 (GPMC_A6)
USR2_LED: D4.2 (A), U6.R14 (GPMC_A7)
USR3_LED: D5.2 (A), U6.P14 (GPMC_A8)
VBAT: J2.1, U6.P8 (VIN_BAT_P8), U6.R8 (VIN_BAT_R8), U6.T8 (VIN_BAT_T8)
VDDSHV: U6.F8 (SYS_VDD3_3P3V_F8), U6.F9 (VDDSHV4), U6.G8 (SYS_VDD3_3P3V_G8), U6.G9 (VDDSHV5), U6.H7 (SYS_VDD3_3P3V_H7), U6.H8 (SYS_VDD3_3P3V_H8), U6.H9 (VDDSHV6), U6.J7 (SYS_VDD3_3P3V_J7), U6.J8 (SYS_VDD3_3P3V_J8), U6.J9 (VDDSHV1), U6.K8 (SYS_VDD3_3P3V_K8), U6.K9 (VDDSHV2), U6.L8 (SYS_VDD3_3P3V_L8), U6.L9 (VDDSHV3)
VDD_1V8: U6.F10 (SYS_VDD_1P8V_F10), U6.G10 (SYS_VDD_1P8V_G10), U6.H10 (SYS_VDD_1P8V_H10), U6.H11 (SYS_VDD_1P8V_H11), U6.J10 (SYS_VDD_1P8V_J10), U6.J11 (SYS_VDD_1P8V_J11), U6.K10 (SYS_VDD_1P8V_K10), U6.L10 (SYS_VDD_1P8V_L10)
VDD_RTC: C10.2, U1.5 (VCC), U6.K11 (SYS_RTC_1P8V_K11), U6.L11 (SYS_RTC_1P8V_L11)

Notes on the sheet:
Gigabit Ethernet
Logic Inputs
SD Card
eMMC
RTC & SPI Flash
USB Ports
Expansion
Serial Debug
Mounting holes

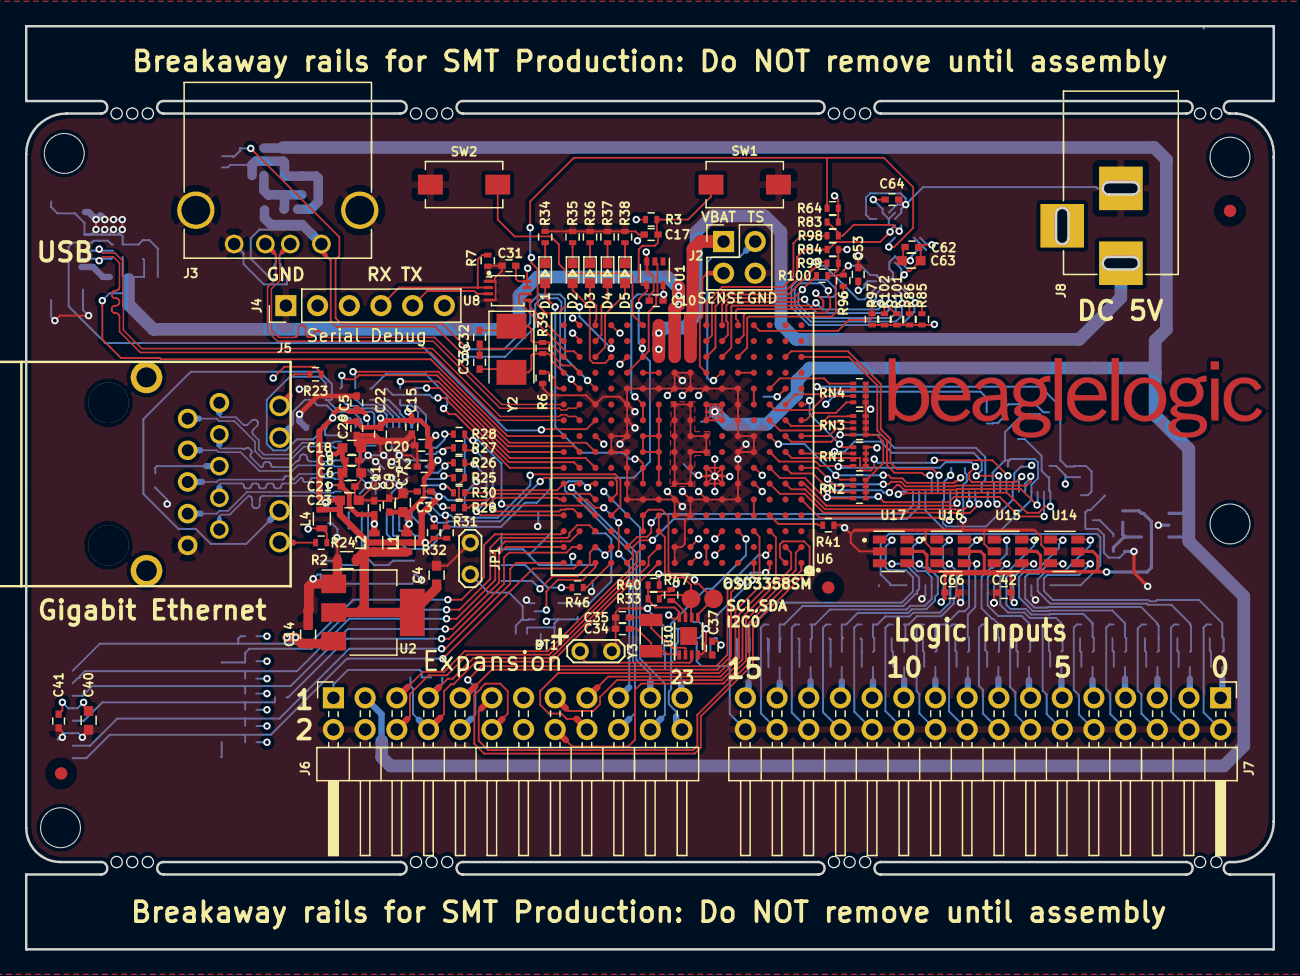
[picture p8: board beaglelogic-standalone.kicad_pcb from above]

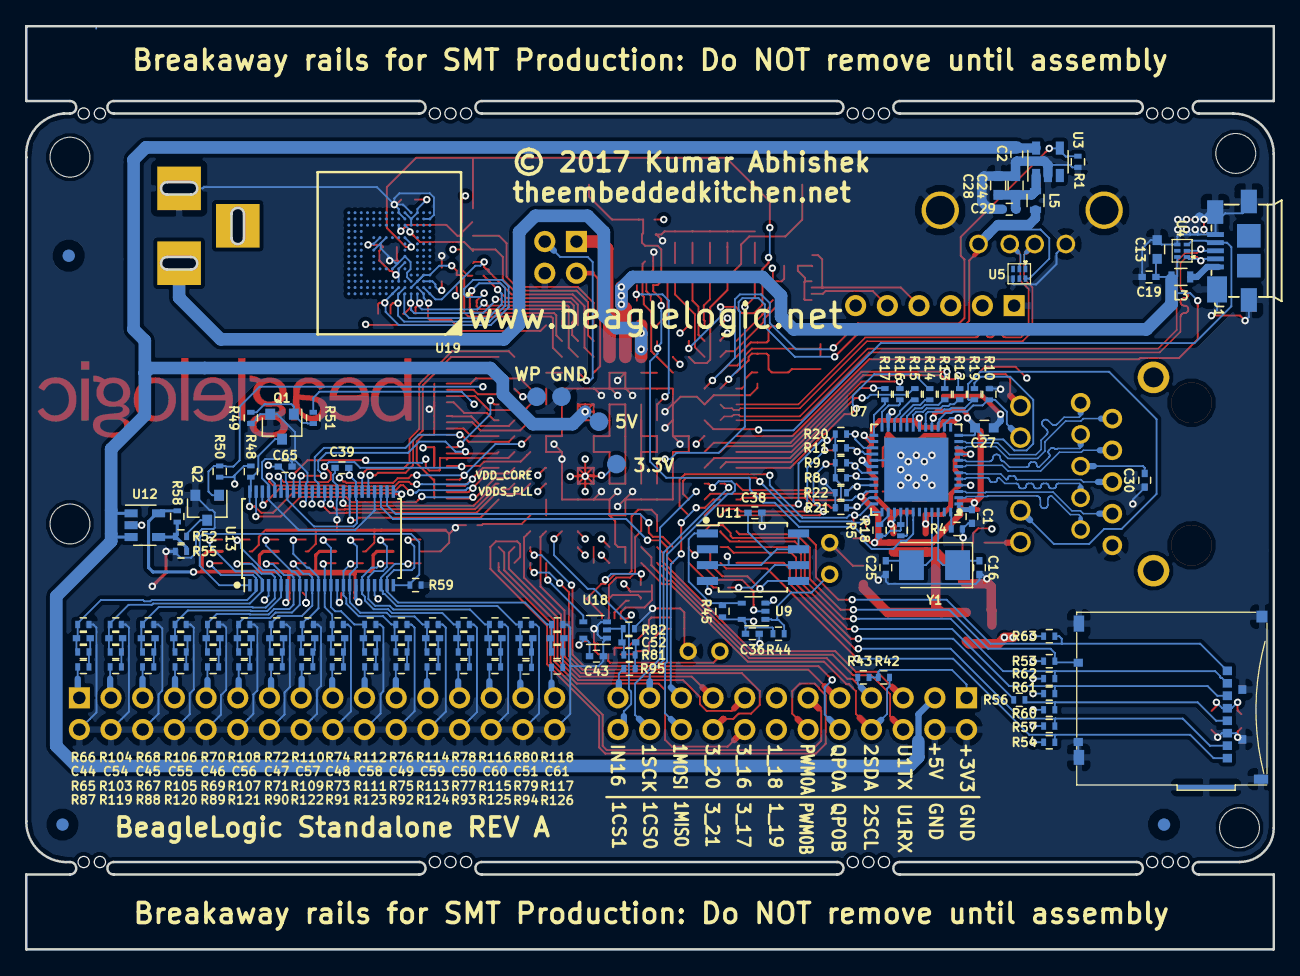
[picture p9: board beaglelogic-standalone.kicad_pcb from below]

Board: 4 copper layers, 100.0 x 74.0 mm, 260 parts (146 on the bottom side), 233 nets.
