abhishek-kakkar/beaglelogic-standalone/(commit log)

2017-07-14 Schematic Commit - Rev A
    [beaglelogic-standalone.sch]
2017-07-15 Fix connection to GND of C31
    Was unconnected though appeared connected
    [beaglelogic-standalone.sch]
2017-07-15 Attach GPIO_OE to its own GPIO instead of SYS_RESETn
    [beaglelogic-standalone.sch]
2017-07-15 Add jumpered buffer to CS line of SPI Flash
    Suggested change by @mwelling to enable recovery from a board brick.
    [beaglelogic-standalone.sch]
2017-07-15 Insert series resistors on SPIF SCK, eMMC CLK and SD CLK
    [beaglelogic-standalone.sch]
2017-07-15 Update to Revision A2
    [beaglelogic-standalone.sch]
2017-07-16 Add pull-ups on I2C2 lines
    [beaglelogic-standalone.sch]
2017-07-28 Replace OSD3358 with OSD3358-SM
    [beaglelogic-standalone.sch]
2017-08-13 Convert to OSD3358-SM: Add missing pins, remove external EEPROM
    [beaglelogic-standalone.sch]
2017-08-14 Footprint assignment completed
    All footprints assigned.
    [beaglelogic-standalone.sch]
2017-08-18 Schematic changes... * Flip D0 to D15 and PRU_IN0 to PRU_IN15 for ease in board layout * Switch OSD3358-SM from 400pin BGA to 256pin BGA package
    [beaglelogic-standalone.sch]
2017-08-18 Flip DP and DM on ESD protector for ease of board layout
    [beaglelogic-standalone.sch]
2017-08-19 PCB layout: Initial commit
    First pass at component placement.
    Also, slight changes in schematic.
    [beaglelogic-standalone.kicad_pcb, beaglelogic-standalone.sch]
2017-08-21 More routing
    [beaglelogic-standalone.kicad_pcb]
2017-08-25 Update routing and schematic
    [beaglelogic-standalone.kicad_pcb, beaglelogic-standalone.sch]
2017-09-02 Finalize board outline to 10cm x 6cm
    [beaglelogic-standalone.kicad_pcb, beaglelogic-standalone.sch]
2017-09-04 Route the eMMC
    [beaglelogic-standalone.kicad_pcb, beaglelogic-standalone.sch]
2017-09-04 Route the expansion header
    [beaglelogic-standalone.kicad_pcb]
2017-09-05 Almost 90% routed
    [beaglelogic-standalone.kicad_pcb]
2017-09-07 Finish routing
    [beaglelogic-standalone.kicad_pcb, beaglelogic-standalone.sch]
2017-09-08 Shrink and add logo
    [beaglelogic-standalone.kicad_pcb]
2017-09-09 Final touches to Rev A
    * Shrink logo to fit on board
    * Add fiducials on board
    * Rotate USB-A connector 90 degrees so that it does not interfere with
    microUSB
    * Add helper text
    [beaglelogic-standalone.kicad_pcb, beaglelogic-standalone.sch]
2017-09-10 Add used PCB footprint modules
2017-09-10 Release Candidate
    * Fix incorrect footprint for MCP79410
    * Adjust footprint for KSZ9031 adding more thermal vias in EP and modifying
    paste pattern
    * Add vias to some unused signals for testing purposes
    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
    [beaglelogic-standalone.kicad_pcb, beaglelogic-standalone.sch]
2017-09-11 RC2
    * Schematic revision updated to A5
    * Add teardrops to tracks connecting to pin header pads
    [beaglelogic-standalone.kicad_pcb, beaglelogic-standalone.sch]
2017-09-12 Prepare design for production
    * Add breakaway rails on long edges of the PCB as required for prod
    * Remove routing from underneath the ethernet PHY QFN
    * Add triangles to indicate LED polarity on the silkscreen
    * Also add pointers on silkscreen to pin 1 of various ICs
    [beaglelogic-standalone.kicad_pcb]
2017-09-12 Prepare for prod: Fix DRC error
    [beaglelogic-standalone.kicad_pcb]
2017-09-13 Release PCB rev A1
    [beaglelogic-standalone.kicad_pcb]
2017-09-13 Update PCB plotting preferences
    [beaglelogic-standalone.kicad_pcb]
2017-10-14 PCB: Update SMD attributes in components
    Needed to generate the Pick-n-Place XY File and ensure all the
    components are there
    [beaglelogic-standalone.kicad_pcb]
2017-10-14 Device Tree: Add device tree source for BeagleLogic standalone
2017-10-21 docs: Add expansion connector page
2017-10-21 docs: Add prototype pictures
