abhishek-kakkar/beaglelogic-standalone/(notices)

Notices in the files:
beaglelogic-standalone.kicad_pcb:
© 2017 Kumar Abhishek
